jhbe/prog-25k50/system_config.h

/* 
 * File:   system_config.h
 * Author: Johan
 *
 * Created on October 2, 2016, 4:58 PM
 */

#ifndef SYSTEM_CONFIG_H
#define	SYSTEM_CONFIG_H

#include "usb_config.h"

#ifdef	__cplusplus
extern "C" {
#endif




#ifdef	__cplusplus
}
#endif

#endif	/* SYSTEM_CONFIG_H */
