jhbe/prog-25k50/(commit log)

2017-02-25 Added driver and updated README.
2017-02-25 Added TDO signal to schematic.
2017-02-25 Added full device list.
2017-03-04 Added KiCad schematics.
    [prog-25k50.kicad_pcb, prog-25k50.sch]
